AtomicAnindya/Inverted-Pendulum-Balance/Inverted_Pendulum_Balancing_using_LQR (2).pdf

### Inverted Pendulum Balancing using LQR Control

A Design Lab Project Report Submitted in Partial Fulfillment of the Requirements for the Degree of

Bachelor of Technology

by

Anindya Biswas | J. Spandhan Srirag
(210108004) | (210102040)

under the guidance of

Dr. Chayan Bhawal

to the

DEPARTMENT OF ELECTRONICS AND ELECTRICAL ENGINEERING

INDIAN INSTITUTE OF TECHNOLOGY GUWAHATI GUWAHATI - 781039, ASSAM

# CERTIFICATE

This is to certify that the work contained in this project entitled “Inverted Pendulum

Balancing using LQR Control” is a bonafide work of Anindya Biswas (Roll No.

210108004) and J. Spandhan Srirag (Roll No. 210102040), carried out in the De-

partment of Electronics and Electrical Engineering, Indian Institute of Technology Guwahati

under my supervision and that it has not been submitted elsewhere for a degree.

Supervisor: Dr. Chayan Bhawal

Assistant Professor,

May, 2024 | Department of Electronics and Electrical Engineering,
Guwahati. | Indian Institute of Technology Guwahati, Assam.

i

ii

# Acknowledgements

We wish to express our deep appreciation to Dr. Chayan Bhawal for his valuable guidance,

assistance, patience and encouragement while developing this project.

We also want to express our sincere gratitude to the Electronics Club, IIT Guwahati for

constantly supporting us with their valuable resources and giving us a working environment.

iii

iv

# Contents

List of Figures | vii
1 Introduction | 1
2 Design of the System | 3
3 Control System Analysis and Design | 11
4 Experimental Results | 23

v

5 Challenges faced and Overcoming them | 27
6 Conclusion and Future Work | 29
References | 31
Appendices | 40

vi

# List of Figures

1.1 Simple Inverted Pendulum Balancing System | | 1
2.1 Block Diagram of Closed-loop Control System | | 3
2.2 Components of Inverted Pendulum Balancing System | | 4
2.3 Orthographic View of the Model | | 4
2.4 Right Side View | | 5
2.5 Front View | | 5
2.6 Top View | | 5
2.7 Rhino 100RPM motor | | 6
2.8 Incremental Optical Rotary Encoder | | 7
2.9 Hall Effect Magnetic Encoder | | 7
2.10 The Physical Setup | | 8
2.11 Power Supply & Control Unit | | 9
3.1 Inverted pendulum with slider | 12
3.2 Free body diagram of cart(slider) | 12
3.3 Free body diagram of pendulum | 13
3.4 Circuit of DC Motor | 15
4.1 Simulated Response of the System | 24
4.2 Simulated Input Voltage | 24
4.3 Response of the Physical system | 25
4.4 Input Voltage to the System | 25

vii

viii

# Chapter 1

# Introduction

### 1.1 Problem

An inverted pendulum is a fascinating mechanical system (as shown in fig. 1.1 ) where unlike the

conventional pendulum, pendulum rod oscillates in upright position. The inverted pendulum

is inherently unstable. Without any control mechanism, it would simply fall over.

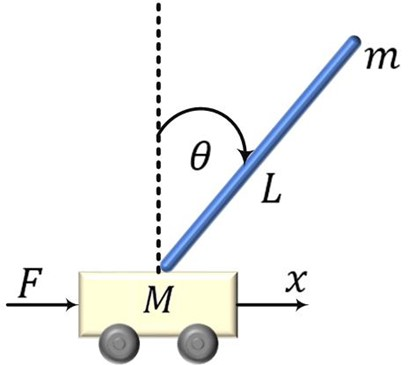
[picture p1: figure]

Fig. 1.1: Simple Inverted Pendulum Balancing System

To keep the inverted pendulum stable in vertically up position, we rely on feedback control

systems. These systems continuously monitor the pendulum’s angle and adjust the position

of the pivot point horizontally when the pendulum starts to tilt. By doing so, they maintain

balance and prevent the pendulum from toppling over.

This system, also referred to as the Broom-balancer, tackles a challenge akin to balancing

a broomstick. Its practical application lies in controlling the orientation of missiles or rockets during their initial launch stages. Imagine a satellite booster rocket, resembling a colossal

broomstick in terms of aerodynamics, requiring precise balance through engine rotation to

align with its thrust vector. For our project, we simplify the problem from three dimensions to

two, focusing solely on pendulum motion within a plane and restricting cart movement to the

horizontal axis.

### 1.2 Objective

The primary objective of this project is to develop and build a balancing system for an inverted

pendulum that meets specified performance criteria. The design process encompasses both

mechanical and control system aspects. In mechanical system design, tasks involve structuring

the system, selecting and designing components, and identifying suitable sensors for measur-

ing linear and angular displacements and velocities. Control system design entails analyzing

feedback control systems, establishing mathematical models of the dynamic system, deriving

motion differential equations, linearizing equations around a given operating point, scrutinizing

feedback control system characteristics, and crafting feedback controllers using state feedback

control methods and linear optimal control techniques.

# Chapter 2

# Design of the System

### 2.1 Basic Components of the System

A typical feedback control system is a closed loop system comprising of: (1) A plant: a system

that needs to be controlled; (2) a sensor network: systems that provides information about the

plant and sends it back to a controller; and (3) a controller: the central processing unit of the

control system which compares the measurements from the sensors and adjusts the input to

the plant such that the output of the plant is maintained at the desired value.

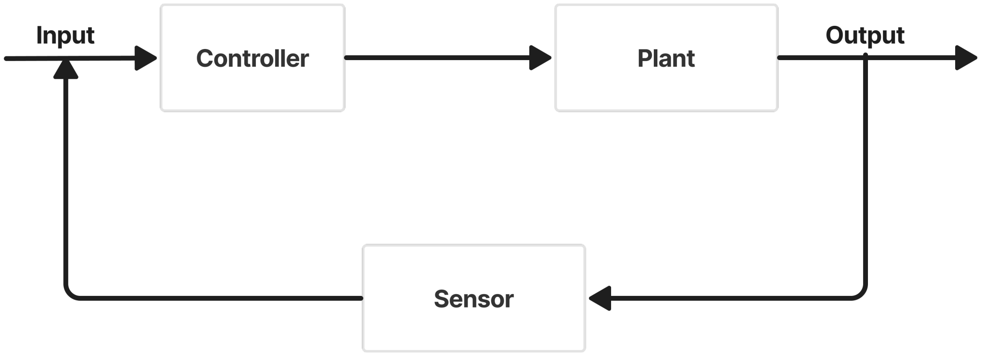
[picture p2: figure]

Fig. 2.1: Block Diagram of Closed-loop Control System

Figure 2.1 shows a typical closed loop system. Conforming to the block diagram in Figure

2.1, the inverted pendulum set-up designed in this work admits the following basic blocks: (1)

Plant: the inverted pendulum and the platform to which the pendulum is to be attached; (2) a sensor network: this comprises of the sensors to detect the angular position, angular velocity of

the pendulum and also the linear position and linear velocity of the cart; , and (3) a controller:

this is an Arduino based controller which takes the readings from the sensors, processes them

to provide the actuating signals to the cart. The block diagram of the designed system is shown

in fig. 2.2 .

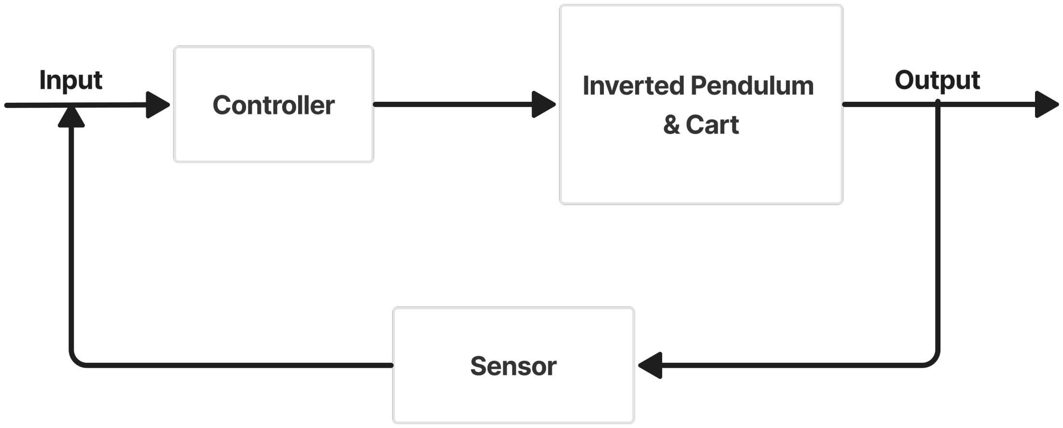
[picture p3: figure]

Fig. 2.2: Components of Inverted Pendulum Balancing System

### 2.2 Decided Model

There are many factors to consider before we chose our design. We had to consider our budget,

the availibilty of components, the complexity to build the system, cost of the sensors etc. After

considering all those we finally decided to proceed with the model as shown in fig. 2.3.

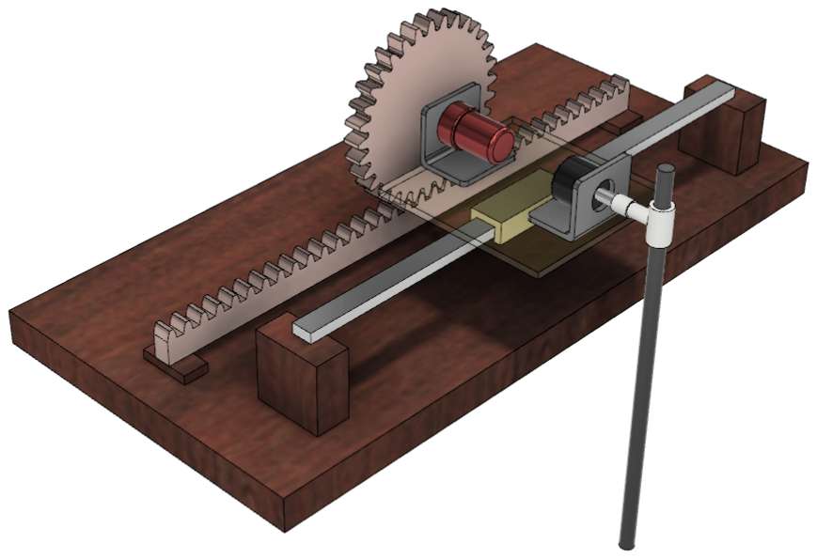
[picture p4: figure]

Fig. 2.3: Orthographic View of the Model

### 2.2.1 Cart and Pendulum

As shown in fig. 2.3, the cart (yellow colored) is mounted on the linear slide rail which is fixed

on the wooden platform. The cart can be moved along the rail by applying the torque on the

pinion gear that is attached with the DC motor shaft. Between the cart and rail, bearing balls

and lubricants are used to reduce friction. On the top of the cart, a rectangular transparent

acrylic sheet is placed to attach other components to the cart. Two L-clamps are attached to

the acrylic sheet, one for holding optical rotary encoder (black colored), the other for holding

the DC motor (red colored). The pendulum rod is attached to the rotary encoder using a clamp

(white colored). The rotary encoder is used to measure the angular position of the pendulum.

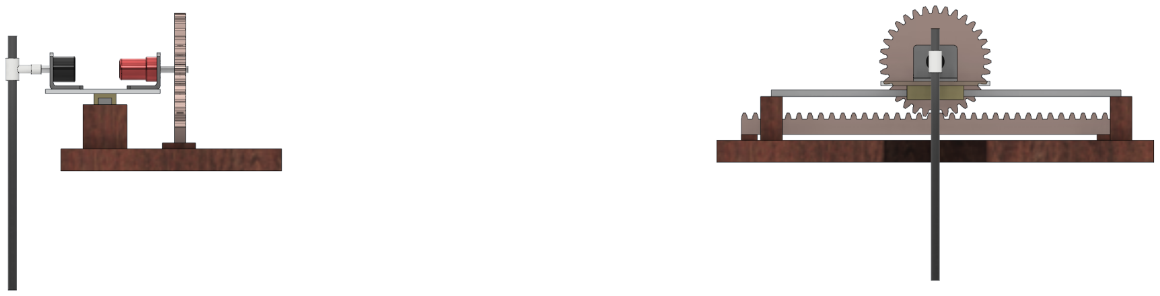
[picture p5: figure]

Fig. 2.4: Right Side View | Fig. 2.5: Front View

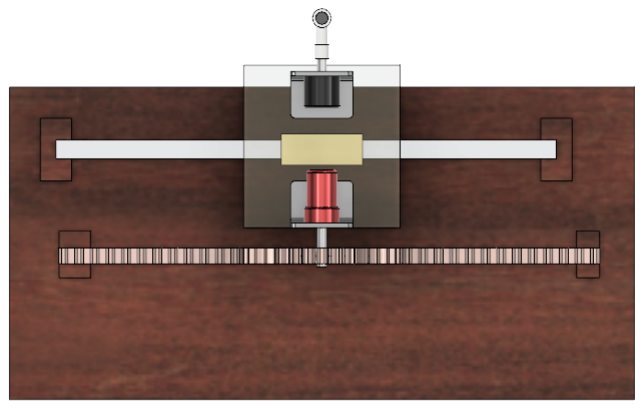
[picture p6: figure]

Fig. 2.6: Top View

### 2.2.2 DC Motor

In the system, the DC motor is fixed on an L-clamp, and a 3D-printed pinion gear is attached

to the shaft of the motor. The pinion gear runs on the rack gear that is attached to the wooden

platform.

The DC motor we have selected for this purpose is RHINO HEAVY DUTY PLANETARY

GEARED MOTOR. The specifications of the DC motor which were chosen in the design are

as follows:

Operating voltage = 12 V;

Motor Speed at Output Shaft = 103 RPM;

Stall Torque = 75 Kgcm;

Rated Torque = 25 Kgcm;

Gear Ratio = 1:174;

Weight = 300 g.

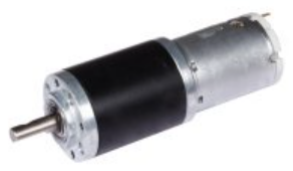
[picture p7: figure]

Fig. 2.7: Rhino 100RPM motor

### 2.2.3 Sensors

An incremental optical rotary encoder has been used to measure the angular position of the

pendulum. Hall effect magnetic encoder has been used to measure the angular position of the

motor shaft and eventually the linear position of the cart.

Specifications of Rotary Optical Encoder:

Model No. – 3806-OPTI-600-AB-OC

Encoder Type – Incremental

Operating Voltage (VDC) – 5 ∼ 24

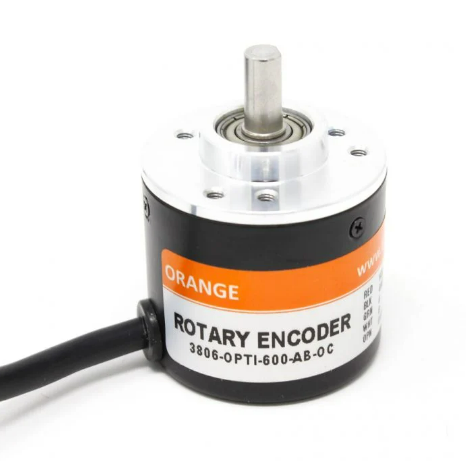
[picture p8: figure]

Fig. 2.8: Incremental Optical Rotary Encoder

Current Consumption (mA) – ≤ 40

Maximum Speed – 5000 RPM

Pulse Per Revolution (PPR) – 600

Counts Per Revolution (CPR) – 2400

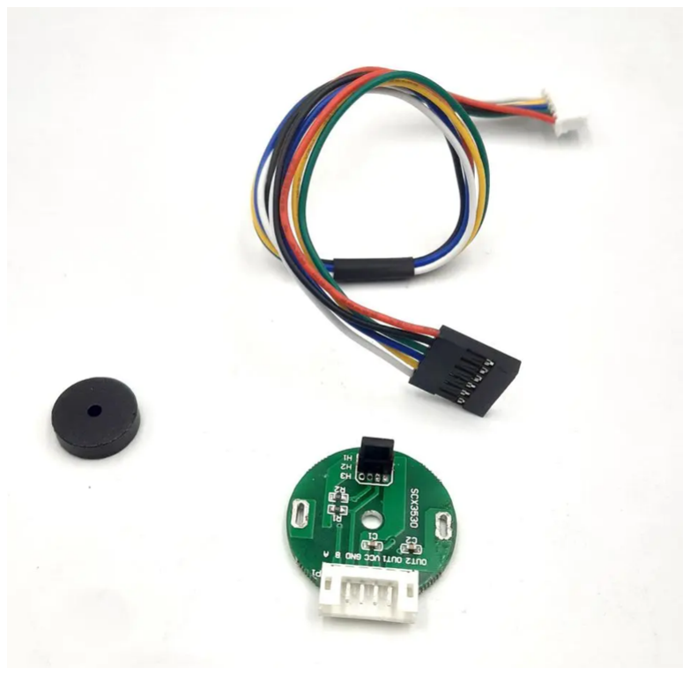
[picture p9: figure]

Fig. 2.9: Hall Effect Magnetic Encoder

Specification of the Hall Effect Magnetic Encoder:

Model No. – SCX3530

Input Supply voltage(V) – 4.5 ∼ 18

Supply Current(A) – 8

Output Current(A) – 0.1

The angular velocity of the pendulum and linear velocity of the cart has been calculated from

those measured quantities.

### 2.3 Mechanical Parts

We used the 3D printing facility through Electronics Club, IITG to print the mechanical parts

such as the the pinion gear that runs on the rack (linear) gear. We 3D printed the clamps

to attach motor and rotary optical encoder to the platform. Also, the joint used to join the

pendulum and the shaft of the encoder was 3D printed. The rack gear is made of transparent

acrylic sheets, which were cut using laser cutter facility available in the New SAC.

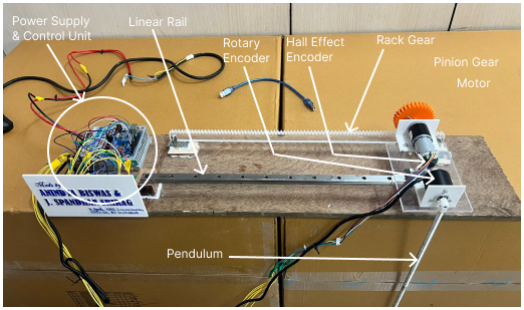
[picture p10: figure]

Fig. 2.10: The Physical Setup

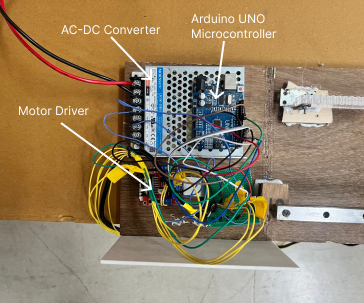
[picture p11: figure]

Fig. 2.11: Power Supply & Control Unit

# Chapter 3

# Control System Analysis and Design

In this chapter we present the dynamic equations governing a typical inverted pendulum set-up.

### 3.1 Dynamic Equations

In order to design a controller to stabilize a inverted pendulum, we need to determine the

dynamical equations governing the system. We reprodue the equations from [2] next. The

system in fig. 3.1 houses a cart and an inverted pendulum attached to the cart. We define the

following variables for the slider:

1. Mass of the cart: M.
2. Mass of the pendulum: m.
3. Length of the pendulum: 2 × l.
4. Force applied to the cart to keep the pendulum upright: f.
5. Position of the cart: x.
6. Angular positio of the pendulum: θ.

The free-body diagram of the slider is shown in fig. 3.2.

We define the following variables for the cart:

1. Horizontal force exerted by the cart on the pendulum: Hf .

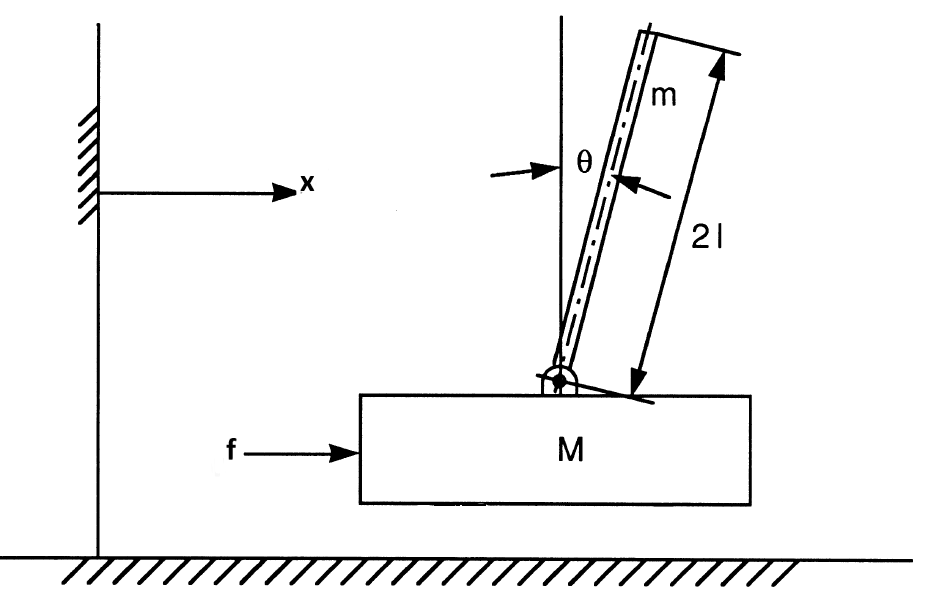
[picture p12: figure]

Fig. 3.1: Inverted pendulum with slider

2. Vertical force exerted by the cart on the pendulum: Vf .
3. Viscous friction coefficient for rotary motion of the pendulum: b2.
4. Viscous friction coefficient for linear motion of the cart b1.
5. Acceleration due to gravity: g.
6. Moment inertia of pendulum with respect to the center of gravity: I.

The free-body diagram of the pendulum is shown in fig. 3.3.

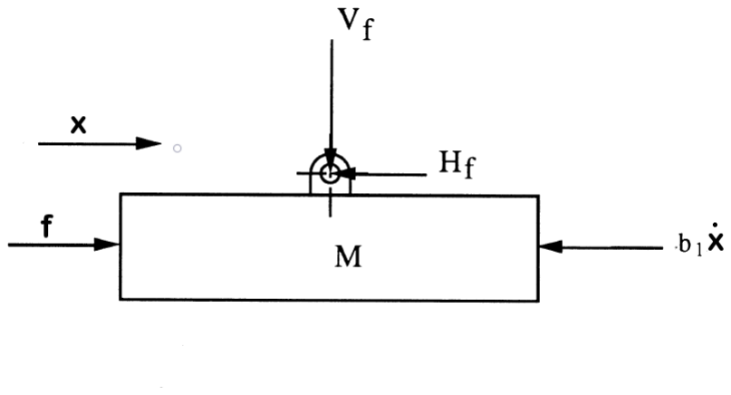
[picture p13: figure]

Fig. 3.2: Free body diagram of cart(slider)

By applying Newton’s second law to the horizontal motion of the cart, and to the horizontal, vertical and rotary motions of the pendulum, we have the following equations.

Mx¨ = f − Hf − b1x˙ | (3.1)

Vf − mg = m

d

2
(lcosθ) dt
2 | (3.2)

Hf = m

d

2
(x + lsinθ) dt
2 | (3.3)

I

¨θ = (Vf sinθ − Hf cosθ)l − b2
˙θ | (3.4)

where, I =

1
3ml²

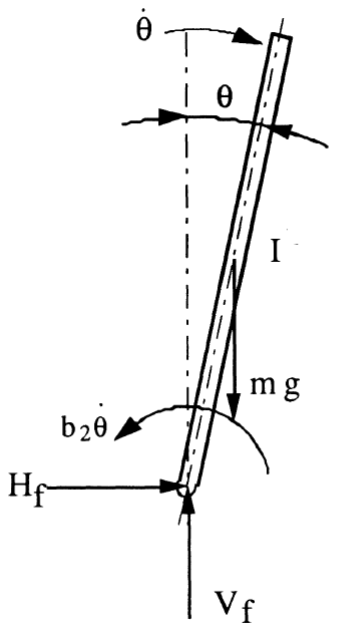
[picture p14: figure]

Fig. 3.3: Free body diagram of pendulum

The viscous friction coefficients b1 and b2 are neglected because in the physical model, all the components that experience friction are properly lubricated. Now, substituting the values

of Vf and Hf in eq. 3.1 and 3.4 we get the following equations.

I

¨θ = l(mgsinθ − mxcosθ ¨ | − ml¨θ) | (3.5)

f = (M + m)¨x + ml¨θcosθ − ml ˙θ
2
sinθ | (3.6)

The non-linear equations in eq. (3.5) and eq. (3.6) are linearized first with the assumption that

θ and ˙θ will be small. Since the objective of controlling the system is to keep the pendulum

upright, it is reasonable to assume that θ and ˙θ will remain close to zero. With this assumption,

the equations can be linearized by retaining only those terms that are linear in θ and ˙θ and

neglecting higher order terms because they will be insignificantly small when θ and ˙θ are close

to zero. So after simplifications, we get the following equations from eq. 3.5 and 3.6.

I

¨θ = lmgθ − lmx¨ − ml² ¨θ | (3.7)
f = (M + m)¨x + ml¨θ | (3.8)

### 3.2 DC Motor Characteristics and State Space

We need to obtain the characteristics[1] of the DC motor being used so that we can calculate

the voltage required to exert a certain force on the slider. We start by modeling the DC motor

as shown in the circuit below.

In the circuit above we see various parameters. These are:

Vm: The input armature voltage of the DC motor; (V)

i: The armature current of the DC motor; (A)

Rm: The armature resistance of the DC motor; (Ω)

Lm: The armature inductance of the DC motor; (H)

Tm: The output torque of the DC motor; (Nm)

θm: The angular position of the motor shaft; (rad)

Motor parameters are obtained as below by fitting the practical dataset to the simulated dataset

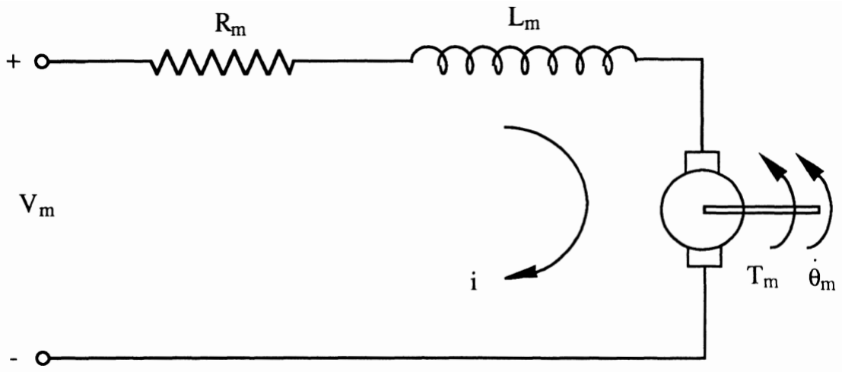
[picture p15: figure]

Fig. 3.4: Circuit of DC Motor

using MATLAB Parameter Estimation utility.

The torque constant, KT = 0.0459 N · m/A;

The e.m.f. constant, Kb = 0.23 V · s/rad;

The armature resistance, R = 2 Ω;

The armature inductance, L = 2 mH;

The Moment of inertia of motor shaft, I = 0.05 kg · m² .

Tm = KT i − b

˙θm | (3.9)

(where KT is the torque constant and b is the viscous friction coefficient of the motor.)

Now by applying KVL on the above circuit, we get.

Vm = Lm

di
dt

+ iRm + Ke

˙θm | (3.10)

(where Ke is emf constant of motor)

Dividing by Rm on both sides.

Vm
Rm

=

Lm
Rm

di
dt

+ i +

Ke

˙θm

Rm

(3.11)

As the value of Lm
Rm

is very small we will approximate it to zero. Now we get an expression for i, by substituting in eq. 3.9 we get.

Tm =

KT Vm
Rm

−

KT Ke
Rm

˙θm − b

˙θm | (3.12)

By equating motor’s torque to force applied we get.

Tm − fr = Im

¨θm | (3.13)

(where Im is moment of inertia of motor shaft)

x = θmr | (3.14)

From eq. 3.8 and 3.13 we get

(m + M)rx¨ + mlr¨θ = Tm − Im

x¨
r

(3.15)

Substituting result of eq. 3.12 in eq. 3.15 we get

((m + M)r

2 + Im)

x¨
r
+ mlr¨θ = Tm | (3.16)

Substituting result of eq.3.12 we get

((m + M)r

2 + Im)

x¨
r

+ mlr¨θ =

KT Vm
Rm

−

KT Ke
Rm

x˙
r

− b

x˙
r

(3.17)

Now if we consider x, ˙x, θ,

˙θ as four states from eqs. 3.17 and 3.8 we get the final state space

as

x˙

x¨

˙θ

¨θ

=

0 1 | 0 0
0 a1 | a2 | 0
0 0 | 0 1
0 a3 | a4 | 0

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
Vm | (3.18)

Where

a1 =

−(I+ml²

)( KT Ke
Rm

+b)
∆

;

a2 =

−m²
l

2gr²
∆

;

a3 =

(

KT Ke
Rm

+b)ml
∆

;

a4 =

((m+M)r

2+Im)mlg
∆

;

b1 =

(I+ml²
)KT r
∆Rm

;

b2 =

−mrlKT
∆Rm

;

∆ = ((m + M)r

2 + Im)I + Mmr²
l

2 + mIml

2

This can be written in the form

X˙ = AX + BU | (3.19)

Where

A =

0 1 | 0 0
0 a1 | a2 | 0
0 0 | 0 1
0 a3 | a4 | 0

(3.20)

B =

0

b1

0

b2

(3.21)

U = Vm | (3.22)

Substituting the values

M = 0.545 Kg;

m = 0.133 Kg;

l = 0.2125 m;

I = 0.002 Kgm²
;

Im = 0.407 73 Kgm²
;

b = 0.424 26 Kgs⁻¹
;

Lm = 6.257 H;

Rm = 136.51 Ω;

KT = 386.05 N · m/A;

Ke = 0.6392 V · s/rad;

r = 0.032 m;

g = 9.8 m/s

2
;

We get

A =

0 | 1 | 0 | 0

0 −5.4661 −0.0025 0

0 | 0 | 0 | 1
0 19.2920 | 34.5969 0

(3.23)

B =

0

0.2216

0

−0.7822

(3.24)

### 3.3 Controllability and Observability

Before designing a controller we need to first check the controllability and observability of the

above system.

For linear systems if there exists an input U that can drive system from initial state to zero

state in finite time then the particular state is said to be controllable. If all initial states are

controllable, the system is said to be completely state controllable.

Compute controllability matrix.

Γc =

B AB A²B A³B
(3.25)

Γc =

0 | 0.2216 | −1.2114 | 6.6237
0.2216 | −1.2114 | 6.6237 | −36.2162
0 | −0.7822 | 4.2757 | −50.4334
−0.7822 | 4.2757 | −50.4334 275.7094

(3.26)

rank(Γc) = 4 | (3.27)

From eq. 3.27 we can say that the system is completely state controllable.

For the construction of the states from the output it should satisfy the observability condition.

C =

1 0 0 0

0 1 0 0

0 0 1 0

0 0 0 1

(3.28)

Γo =

C

T AT C

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
(3.29)

Γo = 0.001

0.0010 | 0 | 0 | 0
0 | 0.0010 | 0 | 0
0 | 0 | 0.0010 | 0
0 | 0 | 0 | 0.0010
0 | 0.0010 | 0 | 0
0 | −0.0055 −0.0000 | 0
0 | 0 | 0 | 0.0010
0 | 0.0193 | 0.0346 | 0
0 | −0.0055 −0.0000 | 0
0 | 0.0299 | 0.0000 | −0.0000
0 | 0.0193 | 0.0346 | 0
0 | −0.1055 −0.0000 | 0.0346
0 | 0.0299 | 0.0000 | −0.0000
0 | −0.1634 −0.0002 | 0.0000
0 | −0.1055 −0.0000 | 0.0346
0 | 1.2438 | 1.1972 | −0.0000

(3.30)

rank(Γo) = 4 | (3.31)

From eq. 3.31 we can say that the system is completely observable. As the system is observable

as well as controllable, the system can be made stable by feedback through an observer.

### 3.4 Controller Design

We have used the optimal control method for our controller design. The controller is achieved

by working with quadratic performance indices and minimizing a specified performance crite-

rion. This gives us best controller according to the cost assigned to each state and the cost assigned to control input.

The controller is called as LQR (Linear Quadratic Regulator) controller[3]. For a linear

system X˙ = AX + BU the optimal controller is obtained by minimizing the cost function J of

the form

J =

1
2

Z ∞

0

(X

TQX + U

TRU) dt | (3.32)

The controller is given by

U = −KX | (3.33)

K = R

−1B
TP | (3.34)

In the above equations

P : symmetric and positive definite matrix;

Q : symmetric and positive semidefinite matrix;

R : symmetric and positive definite matrix.

The weighting matrices Q and R are usually diagonal. The terms XTQX and U

TRU of the

integrand are quadratic forms which measure, respectively, the performance and the cost of

control. So choosing Q and R is very important.

According to the tolerable error limits of all the states and motor capacity through various

iterations in Matlab matrices Q and R are chosen as

Q =

100 | 0 | 0 | 0
0 | 199 | 0 | 0
0 | 0 | 100 | 0
0 | 0 | 0 | 199

(3.35)

R = 10000 | (3.36)

These Q and R values are used to compute K matrix using Matlab code. The K Obtained is

K =

−0.0838 −45.3809 −156.9463 −26.6846 (3.37)

# Chapter 4

# Experimental Results

At first, we have simulated our designed model on MATLAB and checked for different perfor-

mance criteria. Then we performed the experiment on our physical model.

### 4.1 Matlab Simulation

For the designed controller in the above section, simulation is performed giving an initial de-

flection. Initial values of the states are :

x = 0.00 m

x˙ = 0.00 m

θ = 0.05 rad

˙θ = 0.1 rad/s

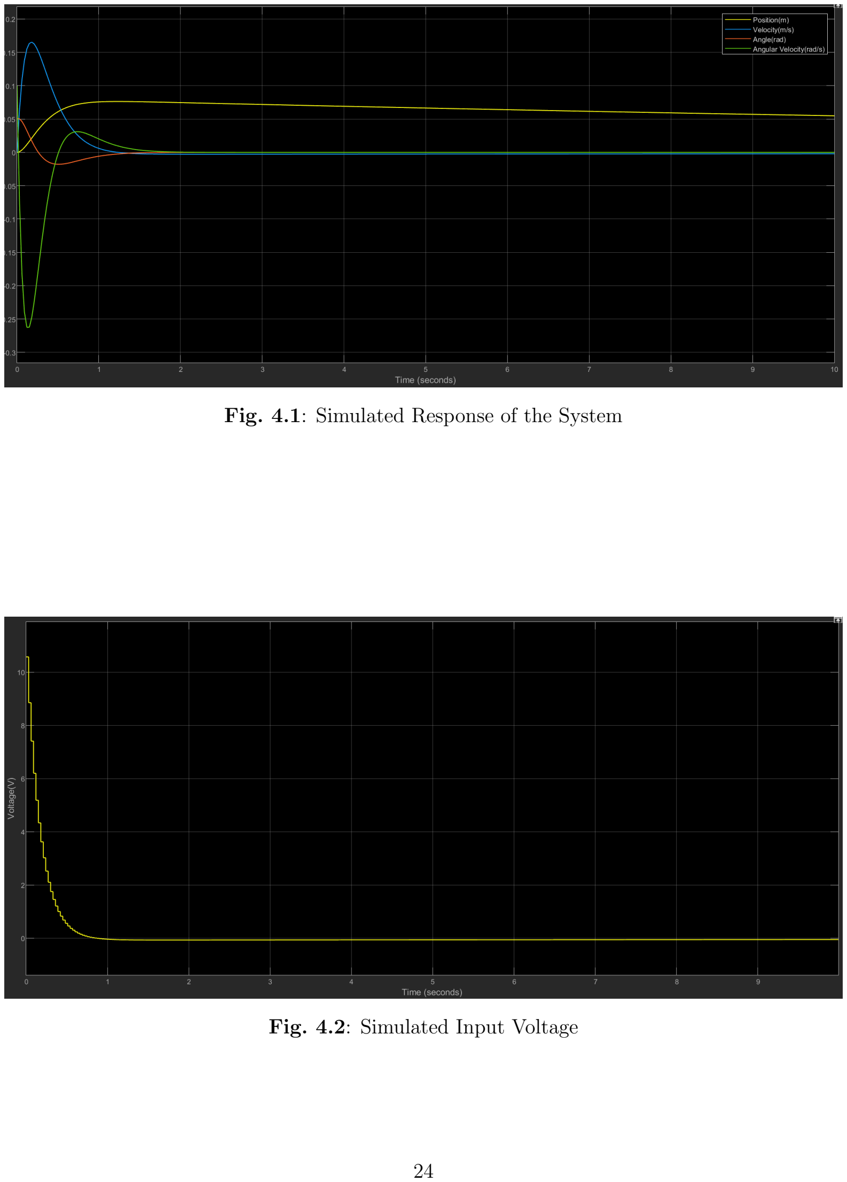
[picture p16: page 33]

Fig. 4.1: Simulated Response of the System

Fig. 4.2: Simulated Input Voltage

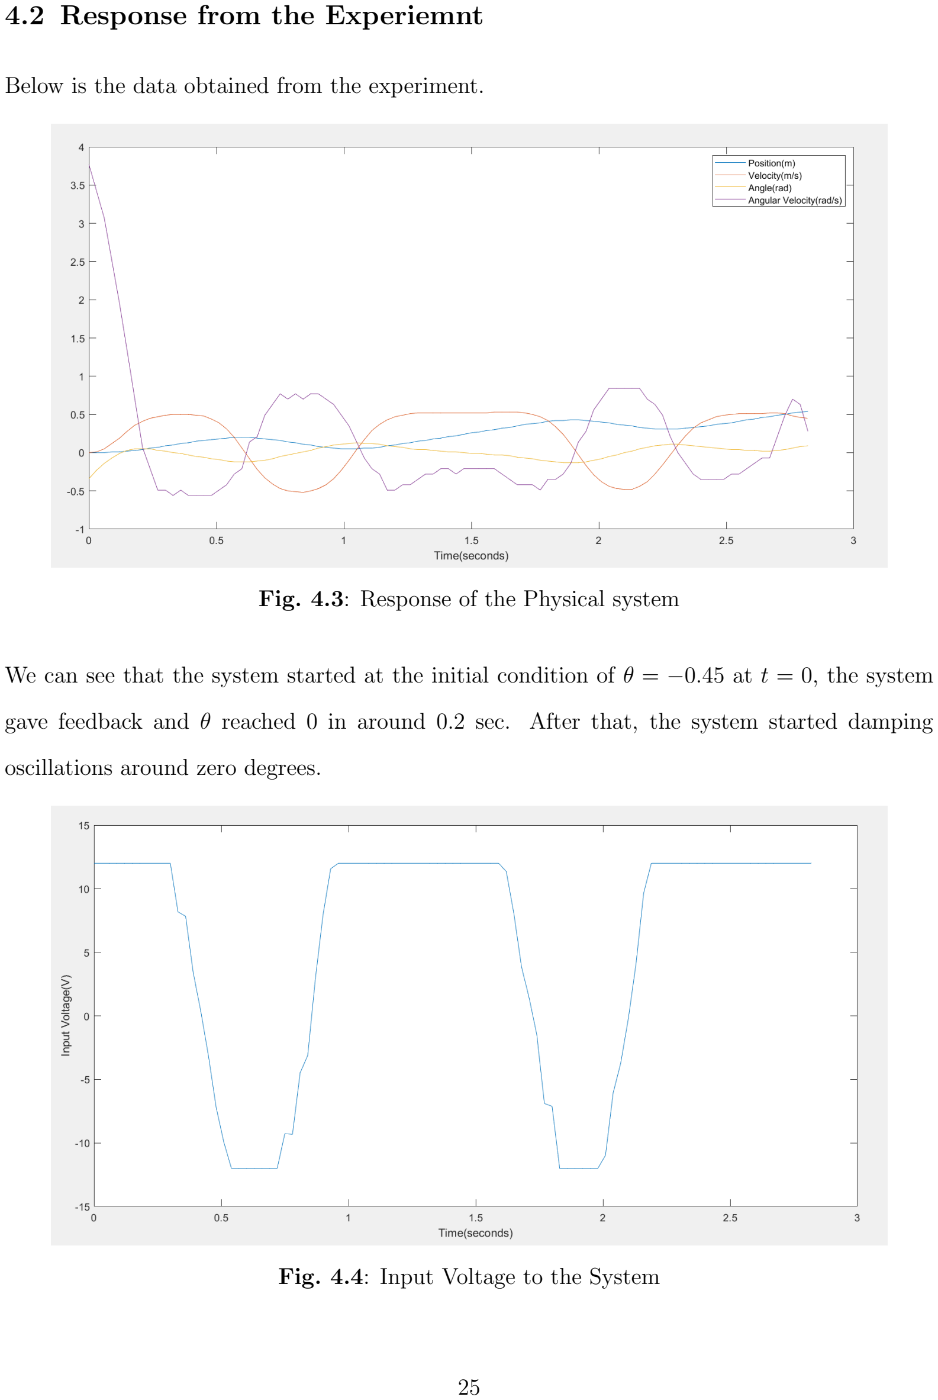
[picture p17: page 34]

### 4.2 Response from the Experiemnt

Below is the data obtained from the experiment.

Fig. 4.3: Response of the Physical system

We can see that the system started at the initial condition of θ = −0.45 at t = 0, the system

gave feedback and θ reached 0 in around 0.2 sec. After that, the system started damping

oscillations around zero degrees.

Fig. 4.4: Input Voltage to the System

If we observe carefully we can see that the voltage input given to the motor matches with

the change in states and we can see that the voltage is switching between positive and negative

values which signifies oscillations.

# Chapter 5

# Challenges faced and Overcoming them

We initially used Johnson 60 RPM DC motor for the system. We did the primary calculations

for the speed of the cart provided by this motor but it was falling short of the required speed.

Then we switched to Johnson 300 RPM DC motor but this time it fell short of the required

torque. Then we finally switched to RHINO 100 RPM motor which provided us with decent

torque and speed.

As we were using LQR for the controller we needed to retain the state space for feedback.

To retain the state space we need all the characteristics and transfer function of the DC motor.

For this, we took the practical readings of the motor’s angular velocity and used this data to

find the best fit for all the values on MATLAB.

Initially, we were using accelerometer for the position and velocity measurement of the cart.

However, this sensor was causing too much error in the measurements. So we have switched to

Hall effect encoder which provided us with better accuracy.

# Chapter 6

# Conclusion and Future Work

### 6.1 Conclusion

The designed system showed a good response. It was able to balance the pendulum for around

five seconds. After that the slider hit the end of the railing. This was expected as the state x

took more time to reach stable state than other states. Moreover, the rail chosen is not long

enough and it might be one of the reasons for poor performance as we suspect the system would

have been able to reach fully stable state if it had been given more space. Utilization of more

precise sensors may help improve the response of the system.

### 6.2 Future Work

We plan to improve the system if provided with proper support and resources. We will try to

make the system with a longer rail so that the slider gets enough spatial freedom to stabilize

the pendulum. More advanced sensors will be used to make the system more accurate and

robust. We also aim to implement swing-up feature in the future.

# References

[1] G. F. Franklin, J. D. Powell, and A. Emami-Naeini. Feedback Control of Dynamic Systems.

Pearson, 2014.

[2] Haqreu. Chewing the linear quadratic regulator to control the inverted pendulum, 2016.

Available at https://habr.com/en/articles/301276/ Accessed on April 12, 2024.

[3] R. | Tedrake. | Linear | quadratic | regulators | (lqr), | 2016. | Available | at

https://underactuated.mit.edu/lqr.html Accessed on April 12, 2024.

# Appendices

The video of the running system and the corresponding codes are also available at github.com/AtomicAnindya/Inverted-

Pendulum-Balance/tree/main (https://github.com/AtomicAnindya/Inverted-Pendulum-Balance/tree/main)

### Appendix A: MATLAB code for analyzing the system

%measured q u a n t i t i e s in SI u n i t s

m=0.133;%pendulum o l d mass

%m=0.070;%new pendu mass

M=0.545;%c a r t mass %0.120

l =0.425/2; %pendulum o l d l e n g t h i s 2 l

%l =0.236/2;%new pendulum l e n g t h i s 2 l

I =(m∗ l ˆ 2 ) / 3;%pendulum moi ab o u t com

b=0.42426;

Im=0.40773;

Kt=386.05;

Ke=0.6392;

Lm=6.257;

Rm=136.51;

r =0.032;

g =9.8;

d=(((M+m)∗ rˆ2+Im )∗ I )+(M∗m∗( r ˆ2 )∗( l ˆ2))+(m∗Im∗( l ˆ 2 ) ) ;

%t h i s i s D in c a l c u l a t i o n ,

%de te rm in an t o f t h a t m a t r ix

a1=(−( I+m∗( l ˆ 2 ) ) ∗ ( ( ( Kt∗Ke)/Rm)+b ) ) / d ;

a2=(−(mˆ2 )∗( l ˆ2 )∗ g ∗( r ˆ2 ) )/ d ;

a3 = ( ( ( (Kt∗Ke)/Rm)+b )∗m∗ l )/ d ;

a4 =(((M+m)∗ rˆ2+Im )∗m∗ l ∗g )/ d ;

A=[0 1 0 0 ; 0 a1 a2 0; 0 0 0 1; 0 a3 a4 0 ] ;

B=[0; ( ( I+m∗ l ˆ2 )∗Kt∗ r ) / ( d∗Rm) ; 0 ; (−m∗ l ∗ r ∗Kt ) / ( d∗Rm) ] ;

C=[1 0 0 0 ] ;

D=0;% t h i s i s D o f s t a t e −s p ace

%% LQR ka p ar ame ter s

Q=[100 0 0 0 ; 0 199 0 0 ; 0 0 100 0 ; 0 0 0 1 9 9 ] ;

R=10000;

%R=1;

K=l q r (A,B,Q,R ) ;

A =A−B∗K;

%% B u il d System

Sys= s s (A,B, C,D) ;

%% D i s c r e t i z a t i o n

Ts =0.03;

Sy s d=c2d ( Sys , Ts ) ;

Ad=Sy s d . a ;

Bd=Sy s d . b ;

Cd=Sy s d . c ;

Dd=Sy s d . d ;

N=zeros (length (Bd ) , 1 ) ;

%% i n i t i a l c o n d i t i o n

x0 =[0; 0 ; 0 . 0 5 ; 0 . 1 ] ;

[ K d ,˜ ,˜]= dl q r (Ad, Bd,Q,R,N ) ;

### Appendix B: Arduino UNO Code

f l o a t M=0.497 ,m=0.164 , r =0.032;

double t , p r e t =0, del taT =30000;

f l o a t vol =0;

f l o a t V=0,X=0,Xprev=0, t h e t a p =0,X tem=0;

f l o a t k 1 =−0.0838, k 2 =−45.3809, k 3 =−156.9463 , k 4 =−26.6846;

f l o a t t h e ta =0, t h e t a p r e v =0,omega=0, the ta tem =0;

double pi =3.1415926535;

v o l a t i l e long co u n t e r1 = 0 , co u n t e r2 =0;

f l o a t th [ 5 ] , x [ 5 ] ;

#def ine motor 6

#def ine i n1 4

#def ine i n2 5

void se tup ( ) {

S e r i a l . b egi n ( 9 6 0 0 ) ;

pinMode ( 2 , INPUT PULLUP ) ;

pinMode ( 3 , INPUT PULLUP ) ;

pinMode (10 , INPUT PULLUP ) ;

pinMode (11 , INPUT PULLUP ) ;

pinMode ( in1 , INPUT ) ;

pinMode ( in2 , INPUT ) ;

a t t a c h I n t e r r u p t ( 0 , ai0 , RISING ) ;

a t t a c h I n t e r r u p t ( 1 , ai1 , RISING ) ;

pinMode ( motor ,OUTPUT) ;

}

void loo p ( ) {

t=mic ro s ( ) ;

the ta tem =(( co u n t e r1 ∗ pi )/300)− pi ;

// t h e t a =( c o u n te r 1 ∗ p i ) / 3 0 0 ;

t h e t a p =( co u n t e r2 ∗2∗ pi ∗ 1 . 4 9 ) / ( 1 2 ∗ 1 7 4 ) ;

// S e r i a l . p r i n t l n ( t h e t a p ) ;

X tem=t h e t a p ∗ r ;

// S e r i a l . p r i n t l n ( t−p r e t ) ;

i f ( ( ( t−p r e t )<=( del taT +10000))&&(( t−p r e t )>=(deltaT −10000)))

{

i f ( p r e t==0)

{

for ( int i =0; i <=4; i++)

{

x [ i ]=X tem ;

th [ i ]= the ta tem ;

}

}

x [4]= x [ 3 ] ;

x [3]= x [ 2 ] ;

x [2]= x [ 1 ] ;

x [1]= x [ 0 ] ;

x [0]= X tem ;

th [4]= th [ 3 ] ;

th [3]= th [ 2 ] ;

th [2]= th [ 1 ] ;

th [1]= th [ 0 ] ;

th [0]= the ta tem ;

t h e ta =(th [0]+ th [1]+ th [2]+ th [3]+ th [ 4 ] ) / 5 ;

X=(x [0]+ x [1]+ x [2]+ x [3]+ x [ 4 ] ) / 5 ;

omega=( the ta−t h e t a p r e v ) / ( del taT /1000000 );

t h e t a p r e v=t h e ta ;

//X=t h e t a p ∗ r ;

V=(X−Xprev ) / ( del taT /1000000 );

Xprev=X;

// i f ( ( t h e t a <( p i /9)&& t h e t a >(−p i /9))&&((X>−0.2)&&(X<0 . 2 ) ) )

i f ( the ta <( pi /9)&& the ta >(−pi /9 ) )

{

vol =(−( k 1 ∗X+k 2 ∗V+k 3 ∗ t h e ta+k 4 ∗omega ) ) ;

}

e l s e

{

vol =0;

}

// v o l =(−( k 1 ∗X+k 2 ∗V+k 3 ∗ t h e t a+k 4 ∗omega ) ) ;

i f ( vol >=12)

{

vol =12;

}

e l s e i f ( vol <=−12)

{

vol =−12;

}

// an al ogW r i te ( motor , ( ( 2 5 5 ∗ v o l ) / 1 2 ) ) ;

i f ( vol >=0){

d i g i t a lW r i t e ( in1 ,LOW) ;

d i g i t a lW r i t e ( in2 ,HIGH ) ;

analogW ri te ( motor , ( ( 2 5 5 ∗ vol ) / 1 2 ) ) ;

}

e l s e

{

d i g i t a lW r i t e ( in1 ,HIGH ) ;

d i g i t a lW r i t e ( in2 ,LOW) ;

analogW ri te ( motor ,( −(255∗ vol ) / 1 2 ) ) ;

}

S e r i a l . p r i n t (X ) ;

S e r i a l . p r i n t ( ” , ” ) ;

S e r i a l . p r i n t (V ) ;

S e r i a l . p r i n t ( ” , ” ) ;

S e r i a l . p r i n t ( t h e ta ) ;

S e r i a l . p r i n t ( ” , ” ) ;

S e r i a l . p r i n t ( omega ) ;

S e r i a l . p r i n t ( ” , ” ) ;

S e r i a l . p r i n t l n ( vol ) ;

p r e t=t ;

}

// t h e t a =( c o u n te r ∗ p i ) / 6 0 0 ;

// a c c e l . g e tE v e n t (& e v e n t ) ;

}

void ai 0 ( ) {

i f ( di gi t al R e a d (10)==LOW) {

co u n t e r1++;

} e l s e {

coun te r1 −−;

}

}

void ai 1 ( ) {

i f ( di gi t al R e a d (11)==LOW) {

coun te r2 −−;

} e l s e {

co u n t e r2++;

}

}
